gvdiaz/Ensayo-estatico-doc/Documentacion/ICD.odt

Título: Definición de interfaz de PCB de ensayo estático

Fecha de creación: 30/07/2019

Última modificación: 01/08//2019

Autor: Gustavo V. Diaz

Eléctricas

1. Entre generador de señales y PCB ensayo OK
2. Entre sensores de banco y PCB ensayo OK
3. Entre osciloscopio y PCB ensayo OK
4. Entre tester y PCB ensayo OK
5. Entre HMI y PCB ensayo OK
6. Grounding a PCB OK

Mecánicas

1. Fijación en gabinete

Definiciones de interfaz eléctrica

Puerto: Interfaz eléctrica al exterior que se encuentra en el dispositivo a conectar. Por ejemplo el puerto del generador de señales es la interfaz de salida del dispositivo. En este caso el conector BNC de salida.

Tipo eléctrico: Es una definición del pin para que sea utilizada en el momento de llevar estas definiciones a KiCad. El programa diferencia a grandes rasgos entre contactos de potencia y señal. Por lo cual en esta distinción se indica si el contacto pertenece al circuito de potencia o es una señal.

Interfaz eléctrica entre generador de señales y PCB de ensayo

Descripción narrativa

El generador cuenta con un conector de salida BNC. Para que llegue la señal del generador al sensor debo conectarlo al PCB. Esto lo hago mediante un cable coaxil con conectores BNC. Por lo cual el conector de entrada de señal del PCB debe ser BNC a chasis.

Resumen

Puerto de generador

Tipo de conector | Género | Nro. de pin | Función | Observación | Tipo eléctrico
BNC a chasis | Hembra | 1 | SGN | Pin interno | señal
| | 2 | Malla | Exterior conector | señal

Puerto de PCB

Tipo de conector | Género | Nro. de pin | Función | Observación | Tipo eléctrico
BNC a chasis | Hembra | 1 | SGN | Pin interno | señal
| | 2 | Malla | Exterior conector | señal

Designador en PCB: J1

Interfaz definida

Puerto a generador

Tipo de conector | Género | Nro. de pin | Función | Observación | Tipo eléctrico
BNC a cable | Macho | 1 | SGN | Pin interno | señal
| | 2 | Malla | Exterior conector | señal

Puerto a PCB

Tipo de conector | Género | Nro. de pin | Función | Observación | Tipo eléctrico
BNC a cable | Macho | 1 | SGN | Pin interno | señal
| | 2 | Malla | Exterior conector | señal

Detalle de cable

Tipo: Coaxil

Interfaz eléctrica entre sensores de banco y PCB

Descripción narrativa

Los sensores debido al incendio tienen parte de sus cables quemados. Por lo cual hay que proveer de conectores de salida a los mismos. Para estos se decidió utilizar conectores DB con carcasa metálica para continuar el blindaje previsto por el cable del sensor. Estos cuentan con dos contactos unifilares y una malla. En el caso del PCB se eligió conectores DB debido a su bajo costo.

Un agregado importante es indicar que son dos los sensores a ensayar por lo cual se debe realizar doble trabajo en cuanto al puerto de sensor.

Resumen

Puerto de sensor

Tipo de conector | Género | Nro. de pin | Función | Observación | Tipo eléctrico
DB9 a cable | Macho | 1 | - | - | -
| | 2 | SGN blanco | Zs1 | señal
| | 3 | SGN negro | GND | señal
| | 4 | - | - | -
| | 5 | - | - | -
| | 6 | - | - | -
| | 7 | - | - | -
| | 8 | - | - | -
| | 9 | - | - | -
| | Carcaza | Malla | - | -

Puerto de PCB

Tipo de conector | Género | Nro. de pin | Función | Observación | Tipo eléctrico
DB9 a chasis | Hembra | 1 | - | - | -
| | 2 | SGN blanco | Zs1 | señal
| | 3 | SGN negro | GND | señal
| | 4 | - | - | -
| | 5 | - | - | -
| | 6 | - | - | -
| | 7 | - | - | -
| | 8 | - | - | -
| | 9 | - | - | -
| | Carcaza | Malla | GND | -

Designador en PCB: J2

Interfaz definida

Puerto a sensor

Tipo de conector | Género | Nro. de pin | Función | Observación | Tipo eléctrico
DB9 a cable | Hembra | 1 | - | - | -
| | 2 | SGN blanco | - | señal
| | 3 | SGN negro | - | señal
| | 4 | - | - | -
| | 5 | - | - | -
| | 6 | - | - | -
| | 7 | - | - | -
| | 8 | - | - | -
| | 9 | - | - | -
| | Carcaza | Malla | - | -

Puerto a PCB

Tipo de conector | Género | Nro. de pin | Función | Observación | Tipo eléctrico
DB9 a chasis | Macho | 1 | - | - | -
| | 2 | SGN blanco | - | señal
| | 3 | SGN negro | - | señal
| | 4 | - | - | -
| | 5 | - | - | -
| | 6 | - | - | -
| | 7 | - | - | -
| | 8 | - | - | -
| | 9 | - | - | -
| | Carcaza | Malla | - | -

Detalle de cable

Tipo: bifilar 1mm2 mallado

Interfaz eléctrica entre osciloscopio y PCB ensayo

Descripción narrativa

En este caso la interfaz eléctrica que une ambos puertos ya está definida por la punta de osciloscopio. Por lo cual el trabajo de coordinación está relacionado con la definición del puerto en PCB.

Resumen

Puerto de osciloscopio punta 1

Tipo de conector | Género | Nro. de pin | Función | Observación | Tipo eléctrico
BNC a chasis | Hembra | 1 | VGEN | Tensión de generador | señal
| | 2 | GNDGEN | Referencia generador | señal

Puerto de PCB punta 1

Tipo de conector | Género | Nro. de pin | Función | Observación | Tipo eléctrico
Pines a PCB | Macho | 1 | VGEN | Tensión de generador | señal
| | 2 | GNDGEN | Referencia generador | señal

Designador de PCB: TP3 (V1) y TP4 (GND)

Puerto a osciloscopio punta 1

Tipo de conector | Género | Nro. de pin | Función | Observación | Tipo eléctrico
BNC a cable | Macho | 1 | VGEN | Tensión de generador | señal
| | 2 | GNDGEN | Referencia generador | señal

Puerto a PCB

Tipo de conector | Género | Nro. de pin | Función | Observación | Tipo eléctrico
Contacto de punta de osciloscopio | | 1 | VGEN | Tensión de generador | señal
| | 2 | GNDGEN | Referencia generador | señal

Detalle de cable

Tipo: -

Descripción narrativa

Ahora se realiza la misma descripción pero para la punta nro 2 del osciloscopio

Resumen

Puerto de osciloscopio punta 2

Tipo de conector | Género | Nro. de pin | Función | Observación | Tipo eléctrico
BNC a chasis | Hembra | 1 | VZS1 | Tensión de sensor | señal
| | 2 | GNDGEN | Referencia generador | señal

Puerto de PCB punta 2

Tipo de conector | Género | Nro. de pin | Función | Observación | Tipo eléctrico
Pines a PCB | Macho | 1 | VZS1 | Tensión de sensor | señal
| | 2 | GNDGEN | Referencia generador | señal

Designador en PCB: TP5 (V1) y TP6 (GND)

Interfaz definida

Puerto a osciloscopio punta 2

Tipo de conector | Género | Nro. de pin | Función | Observación | Tipo eléctrico
BNC a cable | Macho | 1 | VZS1 | Tensión de sensor | señal
| | 2 | GNDGEN | Referencia generador | señal

Puerto a PCB

Tipo de conector | Género | Nro. de pin | Función | Observación | Tipo eléctrico
Contacto de punta de osciloscopio | | 1 | VZS1 | Tensión de sensor | señal
| | 2 | GNDGEN | Referencia generador | señal

Detalle de cable

Tipo: -

Interfaz eléctrica entre tester y PCB ensayo

Descripción narrativa

En este caso la interfaz eléctrica que une ambos puertos ya está definida por las puntas de medición del tester. Por lo cual el trabajo de coordinación está relacionado con la definición del puerto en PCB.

Designador en PCB: TP1 (positivo) y TP2 (negativo)

Interfaz Grounding a PCB

Todas las interfaces y dispositivos utilizados deberán contar con una referencia al potencial de tierra.

PCB

El contacto de este dispositivo con el grounding será al terminal de GNDGEN. Dicho potencial se distribuye por todas las interfaces, como quedó definido anteriormente. De la misma manera los dispositvos como el generador y osciloscopio están referidos al mismo potencial.

Generador de señales y osciloscopio

Ya tienen incorporado su política de grounding, a la cual me adapto.

Tester

No necesita referencia de grounding pero igualmente toma la misma referencia para medir.

Sensores

Debo verificar que el banco de balanceo se encuentre conectado al potencial de tierra.

Designador en PCB: H1, H2, H3 y H4
