gvdiaz/Ensayo-estatico-doc/Documentacion/Ensayo estatico.odt

Título: Propuesta de ensayo en sensor inductivo estático

Proyecto: Balanceadora de José

Autor/es:

- Gustavo V. Diaz

Objetivo:

Relevar funcionamiento en frecuencia de sensores (izquierdo y derecho) para obtener el módulo y fase de la impedancia del sensor cuando se encuentra estático.

Los objetivos secundarios son relevar comportamiento con otras amplitudes de alimentación y relevar comportamiento cuando el cabezal está desplazado de la posición de reposo.

Circuito general propuesto

Este circuito se propone debido a que ofrece una ventaja teniendo en cuenta que la medición se realizará con un osciloscopio analógico. Se elige colocar la referencia de medición en el nodo B debido a que el osciloscopio puede medir ambas tensiones Va y Vc (necesarias para el ensayo) con ese solo punto de referencia.

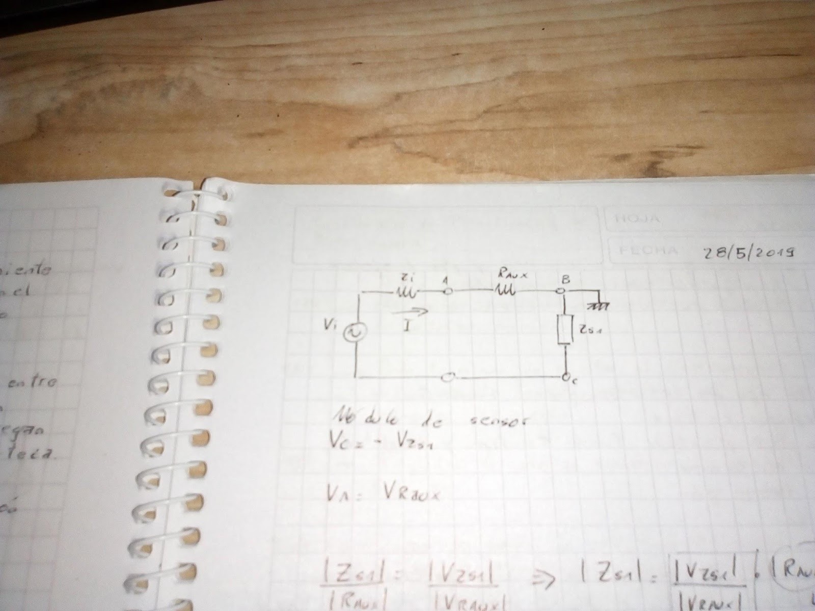
[picture p2: figure]

Ilustración 1: Esquema general de circuito

Si se hubiera elegido como nodo de referencia el C la manera de obtener la tensión Vab hubiera sido restar Va-Vb con lo cual se pone en funcionamiento otro circuito amplificador encargado de la resta de ambas entradas en el osciloscopio con lo cual se aumenta la incerteza de la medición no solo por las puntas sino también por el método utilizado para medir.

La medición que se decidió realizar tiene en cuenta que simplemente se debe invertir la señal medida Vc. Dicha acción no agrega prácticamente incerteza de más, si se lo compara con la resta de señales.

Magnitudes a medir

Dado que se quiere relevar el comportamiento en frecuencia del sensor se debe obtener las siguientes magnitudes:

Z_{S1} = abs{ Z_{S1} } func e^{-j (2 %pi fo+ %alpha_{Z_{S1}} )}

Se conocerá el comportamiento en frecuencia del sensor conociendo el módulo y fase de la impedancia.

Módulo de sensor inductivo

Estas magnitudes se pueden obtener con las siguientes expresiones:

lline {Z_{S1}} rline wideslash {lline {R_{AUX}} rline } = lline {V_{Z_{S1}}} rline wideslash {lline {V_{R_{AUX}}} rline}
newline
newline
lline {Z_{S1}} rline = lline {V_{Z_{S1}}} rline over {lline {V_{R_{AUX}}} rline} cdot lline {R_{AUX}} rline
Expresión 1: Módulo de sensor inductivo

Tanto VZS1 como VRAUX son medidos con el osciloscopio en los valores pico de las ondas medidas. El caso de RAUX su módulo es igual al valor de resistencia cuyo valor se obtiene con el tester.

Fase de sensor inductivo

Parto nuevamente de la definición en fasores de ZS1:

Z_{S1} = abs{ Z_{S1} } func e^{-j (2 %pi fo+ %alpha_{Z_{S1}} )}
newline
Z_{S1} = {abs{ V_{Z_{S1}} } func e^{-j (2 %pi fo+ %alpha_{V_{Z_{S1}}} )}} over {{abs{ I} } func e^{-j (2 %pi fo+ %alpha_{I} )}}
newline
Z_{S1} = R_{AUX} cdot {{abs{ V_{Z_{S1}} } func e^{-j (2 %pi fo+ %alpha_{V_{Z_{S1}}} )}} over {{abs{V_{R_{AUX}}} } func e^{-j (2 %pi fo+ %alpha_{V_{R_{AUX}}} )}}}
newline
Z_{S1} = {{ R_{AUX} cdot abs{ V_{Z_{S1}} }} over {abs{V_{R_{AUX}}}}} cdot { e^{-j [2 %pi fo+ (%alpha_{V_{Z_{S1}}}- %alpha_{V_{R_{AUX}}} )]} }
newline

De donde se obtiene las expresiones de módulo y fase. En particular la expresión de fase del sensor inductivo es:

%alpha_{Z_{S1}} = %alpha_{V_{Z_{S1}}} - %alpha_{V_{R_{AUX}}}
Expresión 2: Fase de sensor inductivo

La medición de dicha magnitud se hace a través de la diferencia de fase entre la tensión del sensor y la tensión de la resistencia auxiliar.

Como conclusión del desarrollo emergen que las mediciones a realizar son:

abs{ V_{Z_{S1}} }:módulo de tensión en sensor inductivo
newline
abs{ V_{R_{AUX}} }: módulo de tensión en resistencia auxiliar
newline
%alpha_{ V_{Z_{S1}} } - %alpha_{ V_{R_{AUX}} }: Diferencia de fase entre sensor y resistencia auxiliar
Expresión 3: Variables a medir

Implementación de medición

Teniendo cómo referencia Ilustración 1: Esquema general de circuito se establece que las mediciones a realizar guardan la siguiente relación con las variables a medir.

V_{Z_{S1}} = - V_{ C } = -V_{ 1 }
newline
V_{R_{AUX}} = V_{ A } = V_{ 2 }

Donde:

- VC: Tensión en nodo C
- V0: Tensión de referencia, en este caso el B
- VA: Tensión en nodo A
- V1: Punta 1 de osciloscopio
- V2: Punta 2 de osciloscopio

Por lo cual lo único que se debe realizar para medir VZS1 es invertir el canal 1. El canal 2 no hace falta que se modifique la fase de la misma.

Ensayos a realizar

Los ensayos a realizar para determinar el comportamiento estático de los sensores inductivos son 6.

Sensor izquierdo

1. Ensayo con tensión nominal (6V) y en posición nominal (en punto de reposo)
2. Ensayo con tensión nominal (6V) y en posición corrida (con tope en cabezal)
3. Ensayo con tensión atenuada (0,6V) y en posición nominal

Secuencia de ensayo nominal (Vin = 6V y posición nominal)

Requerimientos:

- 5 mediciones por década para la variación de frecuencia
- Las frecuencias deben ser elegidas en función de que sean múltiplos de la base de tiempo elegida.

Condiciones iniciales:

- Supongo que cuento con PCB y puntos de medición
- Supongo que cuento con generador de señales
- Supongo que cuento con conexión de sensor

Componentes de ensayo

- Generador de señales
- Cables de alimentación de generador
- Cables de ensayo de generador
- Zapatilla
- Osciloscopio
- Cables de alimentación de osciloscopio
- Puntas de medición de osciloscopio
- PCB de medición
- Separador de cabezal

Secuencia:

1. Acomodar los instrumentos y componentes de manera que sea posible energizar los instrumentos y conectarlos entre si.
2. Energizar los equipos (no habilitar generador)
3. Conectar el osciloscopio con PCB
4. Conectar generador con PCB
5. Conectar banco con PCB
6. Configurar generador de señales y verificar offset
7. Configurar PCB en medición de generador de señales (int.1 e int. 2 posición medición)
8. Habilitar salida de generador de señales
9. Configurar la salida del generador de señales para ensayo
  1. Tensión alimentación 6Vpico
  2. Frecuencia
10. Configurar PCB en medición de ensayo (int. 1 e int. 2 posición ensayo)
11. Configurar osciloscopio para medición de módulo
12. Tomar registro fotográfico y de configuración de osciloscopio
13. Configurar osciloscopio para medición de fase
14. Tomar registro fotográfico y configuración de osciloscopio.
15. Deshabilitar salida de generador de señales
16. Repetir pasos desde punto 6 hasta terminar con las frecuencias preestablecidas y evaluar continuación de ensayo

Secuencia de ensayo con cabezal desplazado (Vin = 6V y posición desplazado)

Requerimientos:

- 3 mediciones por década para la variación de frecuencia
- Las frecuencias deben ser elegidas en función de que sean múltiplos de la base de tiempo elegida.

Condiciones iniciales:

- Supongo que cuento con PCB y puntos de medición
- Supongo que cuento con generador de señales
- Supongo que cuento con conexión de sensor

Componentes de ensayo

- Generador de señales
- Cables de alimentación de generador
- Cables de ensayo de generador
- Zapatilla
- Osciloscopio
- Cables de alimentación de osciloscopio
- Puntas de medición de osciloscopio
- PCB de medición
- Separador de cabezal

Secuencia:

1. Acomodar los instrumentos y componentes de manera que sea posible energizar los instrumentos y conectarlos entre si.
2. Insertar tope para corrimiento de cabezal de sensor
3. Energizar los equipos (no habilitar generador)
4. Conectar el osciloscopio con PCB
5. Conectar generador con PCB
6. Conectar banco con PCB
7. Configurar generador de señales y verificar offset
8. Configurar PCB en medición de generador de señales (int.1 e int. 2 posición medición)
9. Habilitar salida de generador de señales
10. Configurar la salida del generador de señales para ensayo
  1. Tensión alimentación 6Vpico
  2. Frecuencia
11. Configurar PCB en medición de ensayo (int. 1 e int. 2 posición ensayo)
12. Configurar osciloscopio para medición de módulo
13. Tomar registro fotográfico y de configuración de osciloscopio
14. Configurar osciloscopio para medición de fase
15. Tomar registro fotográfico y configuración de osciloscopio.
16. Deshabilitar salida de generador de señales
17. Repetir pasos desde punto 7 hasta terminar con las frecuencias preestablecidas y evaluar continuación de ensayo

Secuencia de ensayo con cabezal desplazado (Vin = 0,6V y posición nominal)

Requerimientos:

- 3 mediciones por década para la variación de frecuencia
- Las frecuencias deben ser elegidas en función de que sean múltiplos de la base de tiempo elegida.

Condiciones iniciales:

- Supongo que cuento con PCB y puntos de medición
- Supongo que cuento con generador de señales
- Supongo que cuento con conexión de sensor

Componentes de ensayo

- Generador de señales
- Cables de alimentación de generador
- Cables de ensayo de generador
- Zapatilla
- Osciloscopio
- Cables de alimentación de osciloscopio
- Puntas de medición de osciloscopio
- PCB de medición
- Separador de cabezal

Secuencia:

1. Acomodar los instrumentos y componentes de manera que sea posible energizar los instrumentos y conectarlos entre si.
2. Insertar tope para corrimiento de cabezal de sensor
3. Energizar los equipos (no habilitar generador)
4. Conectar el osciloscopio con PCB
5. Conectar generador con PCB
6. Conectar banco con PCB
7. Configurar generador de señales y verificar offset
8. Configurar PCB en medición de generador de señales (int.1 e int. 2 posición medición)
9. Habilitar salida de generador de señales
10. Configurar la salida del generador de señales para ensayo
  1. Tensión alimentación 0,6Vpico
  2. Frecuencia inicial
11. Configurar PCB en medición de ensayo (int. 1 e int. 2 posición ensayo)
12. Configurar osciloscopio para medición de módulo
13. Tomar registro fotográfico y de configuración de osciloscopio
14. Configurar osciloscopio para medición de fase
15. Tomar registro fotográfico y configuración de osciloscopio.
16. Deshabilitar salida de generador de señales
17. Repetir pasos desde punto 7 hasta terminar con las frecuencias preestablecidas y evaluar continuación de ensayo

Descripción de banco de medición

Acá debería describir el banco de medición con los bloques que especifiqué en el cuaderno y la descripción de cada uno de los bloques.
