gvdiaz/Ensayo-estatico-doc/Documentacion/Requerimientos PCB ensayo estatico.odt

Última modificación: 19/06/2019

Requerimientos de PCB para ensayo estático

Cumplir con las operaciones requeridas por los ensayos estáticos.

Estas operaciones están descriptas en la secuencia del ensayo

Repaso las operaciones:

Tengo en cuenta la secuencia de ensayo nominal dado que la diferencia entre este ensayo y los otros es que modifica en un caso una condición del sensor (desplazamiento de sensor) y la configuración del generador del señales. No se debe modificar nada relacionado con el PCB

Nro acción | Acción de secuencia | Nro req. | Requerimiento a PCB
1 | Acomodar los instrumentos y componentes de manera que sea posible energizar los instrumentos y conectarlos entre si. | 1 | Diseñar las interfaces eléctricas entre Generador-pcb, Osciloscopio-pcb y sensores-pcb
2 | Energizar los equipos (no habilitar generador) | | -
3 | Conectar el osciloscopio con PCB | | Req. Nro 1
4 | Conectar generador con PCB | | Req. Nro 1
5 | Conectar banco con PCB | | Req. Nro 1
6 | Configurar generador de señales y verificar offset | 5 | El PCB deberá contar con una interfaz para medición de offset con tester.
7 | Configurar PCB en medición de generador de señales (int.1 e int. 2 posición medición) | 2 | El pcb deberá poder ser configurado en modo ensayo o ajuste de generador.
8 | Habilitar salida de generador de señales | 4 | El pcb deberá poder tener una habilitación de señal de entrada propia para el Generador.
9 | Configurar la salida del generador de señales para ensayo | 2.1 | El pcb configurado en ajuste de generador desconecta el circuito de ensayo y conecta directamente los terminales de medición del osciloscopio al generador
10 | Configurar PCB en medición de ensayo (int. 1 e int. 2 posición ensayo) | 2.2 | El pcb configurado en ensayo deberá conectar el circuito de ensayo teniendo en cuenta los puntos de medición del osciloscopio.
11 | Configurar osciloscopio para medición de módulo | 3 | El pcb deberá contemplar la conexión con puntas de osciloscopio para medición en sensor y resistencia auxiliar.
12 | Tomar registro fotográfico y de configuración de osciloscopio | | -
13 | Configurar osciloscopio para medición de fase | | -
14 | Tomar registro fotográfico y configuración de osciloscopio. | | -
15 | Deshabilitar salida de generador de señales | 4 | El pcb deberá poder tener una habilitación de señal de entrada propia para el Generador.
16 | Repetir pasos desde punto 6 hasta terminar con las frecuencias preestablecidas | | -

Resumen de requerimientos:

Funcionales

1. Diseñar las interfaces eléctricas entre Generador-pcb, Osciloscopio-pcb y sensores-pcb
2. El pcb deberá poder ser configurado en modo ensayo o ajuste de generador.
  1. El pcb configurado en ajuste de generador desconecta el circuito de ensayo y conecta directamente los terminales de medición del osciloscopio al generador.
  2. El pcb configurado en ensayo deberá conectar el circuito de ensayo teniendo en cuenta los puntos de medición del osciloscopio.
3. El pcb deberá contemplar la conexión con puntas de osciloscopio para medición en sensor y resistencia auxiliar.
4. El pcb deberá poder tener una habilitación de señal de entrada propia para el Generador.
5. El PCB deberá contar con una interfaz para medición de offset con tester.

Miscelaneos

1. Identificar version de pcb
2. Deberá contemplar agujeros de soporte
3. Deberá implementar prácticas de protección electroestática y de grounding
4. Deberá adaptarse a la implementación de interfaz eléctrica que se consiga en los proveedores.
