gvdiaz/Ensayo-estatico-doc/Documentacion/Tabla de ensayo estatico.pdf

SI 6V nominal

Página 1

Fecha:
Sensor: | Inductivo izquierdo
Tensión alimentación: 6 Vac
Posición cabezal: | Nominal
Nro | Vin; Posición cabezal | Frecuencia | Hora fotografía | Canal 1 | Canal 2 | Observaciones | Magnificador (si/no)
1 a | 6V; nominal | 50
1 b | 6V; nominal | 50
2 a | 6V; nominal | 100
2 b | 6V; nominal | 100
3 a | 6V; nominal | 200
3 b | 6V; nominal | 200
4 a | 6V; nominal | 500
4 b | 6V; nominal | 500
5 a | 6V; nominal | 1000
5 b | 6V; nominal | 1000
6 a | 6V; nominal | 2000
6 b | 6V; nominal | 2000
7 a | 6V; nominal | 5000
7 b | 6V; nominal | 5000
8 a | 6V; nominal | 10000
8 b | 6V; nominal | 10000
9 a | 6V; nominal | 20000
9 b | 6V; nominal | 20000
10 a | 6V; nominal | 50000
10 b | 6V; nominal | 50000
11 a | 6V; nominal | 100000
11 b | 6V; nominal | 100000

SI 6V corrido

Página 2

Fecha:
Sensor: | Inductivo izquierdo
Tensión alimentación: 6 Vac
Posición cabezal: | Corrido
Nro | Vin; Posición cabezal | Frecuencia | Hora fotografí Canal 1 | Canal 2 | Observaciones | Magnificador (si/no)
1 a | 6V; corrido | 50
1 b | 6V; corrido | 50
2 a | 6V; corrido | 100
2 b | 6V; corrido | 100
3 a | 6V; corrido | 200
3 b | 6V; corrido | 200
4 a | 6V; corrido | 500
4 b | 6V; corrido | 500
5 a | 6V; corrido | 1000
5 b | 6V; corrido | 1000
6 a | 6V; corrido | 2000
6 b | 6V; corrido | 2000
7 a | 6V; corrido | 5000
7 b | 6V; corrido | 5000
8 a | 6V; corrido | 10000
8 b | 6V; corrido | 10000
9 a | 6V; corrido | 20000
9 b | 6V; corrido | 20000
10 a | 6V; corrido | 50000
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
2,00E-05 | 0,0002 | 5000
5,00E-05 | 0,0005 | 2000
1,00E-04 | 0,001 | 1000
2,00E-04 | 0,002 | 500
5,00E-04 | 0,005 | 200
1,00E-03 | 0,01 | 100
2,00E-03 | 0,02 | 50
5,00E-03 | 0,05 | 20
1,00E-02 | 0,1 | 10
2,00E-02 | 0,2 | 5
5,00E-02 | 0,5 | 2
1,00E-01 | 1 | 1
2,00E-01 | 2 | 0,5
