gvdiaz/Ensayo-estatico-doc/Documentacion/Materiales de ensayos.ods

Materiales para ensayo estático
Fuente: | Los materiales fueron listados teniendo en cuenta las operaciones necesarias en el ensayo, el esquema del ensayo y el documento de requerimientos del PCB
nro | Componente | Cantidad | Cantidad mín. | Uso
1 | R 15k 1% | 10 | 1 | Resistencia de medición
2 | Conector BNC a PCB | 4 | 1 | Interfaz elec. GEN.
3 | Punto med. PCB | 4 | 2 | Interfaz elec. OSC
4 | Conector bifilar mallado macho a cable | 6 | 4 | Interfaz elec. De sensor y extensor
5 | Conector bifilar mallado hembra a cable | 2 | 1 | Interfaz elec. A PCB sensores
6 | Conector bifiliar hembra a PCB | 2 | 1 | Interfaz elec. A PCB sensores
7 | Interruptor a PCB 2D2T | 4 | 2 | Interruptor de ensayo/medición GEN
8 | Interruptor a PCB 1D2T | 2 | 1 | Interruptor de habilitación de GEN
9 | Gabinete de PCB | 1 | 1 | Contenedor de PCB
10 | Tornillos de fijación | 10 | 4 | Fijación de PCB
11 | Separadores | 10 | 4 | Fijación de PCB
12 | Arandelas | 10 | 8 | Fijación de PCB
13 | Tuercas | 10 | 4 | Fijación de PCB
Materiales para ensayo sensor contador vueltas y desplazamiento
nro | Componente | Cantidad | Cantidad mín. | Uso
1 | Sensor infrarojo | 4 | 2 | Sensor de desplazamiento y contador de vueltas
2
3
4
5
6
7
