gvdiaz/Ensayo-estatico-doc/Documentacion/Costo ensayo.ods

Archivo de costos
Proyecto: | PCB ensayo estático
Autor: | Gustavo V. Diaz
Fecha inicio | 28/08/19
Fecha modificación | 18/09/19
Nro | costo | Descripción | Comprobante | Fecha | Razón social | Cobrado
1 | 230 | PCB | no me dió | 26/08/19 | F. Arredondo | No
2 | 738 | Componentes | 06-15335 | 14/06/19 | uElectrónica | No
3 | 211 | Componentes | 06-15821 | 02/09/19 | uElectrónica | No
4 | 362 | Componentes | 06-85072 | 14/06/19 | SYC | No
5 | 83,27 | Componente | 05-73481 | 17/09/19 | uElectrónica | No
6
7
8
9
10
11
12
13
14
Total | 1624,27
