gvdiaz/Ensayo-estatico-doc/Documentacion/Kicad Like a Pro 2 illustrations.pdf

# The Kicad design workflow

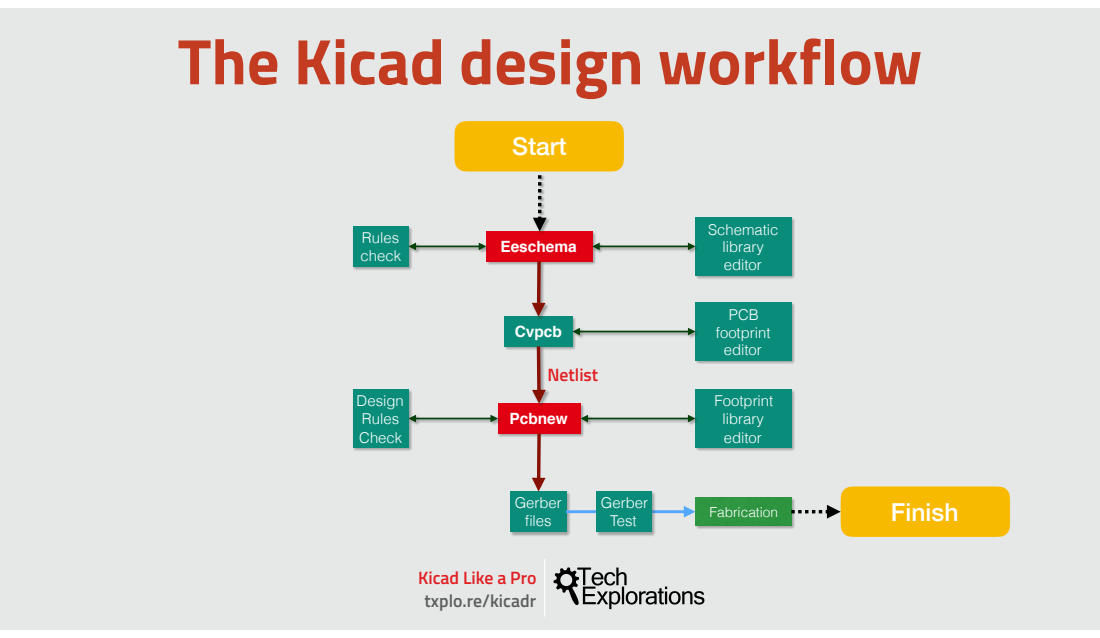
[picture p5: page 1]
Eeschema; Cvpcb; Pcbnew; Design Rules Check; PCB footprint editor; Gerber; files; Fabrication; Rules check; Schematic library editor; Footprint library editor; Start; Test; Finish; Netlist

Kicad Like a Pro
txplo.re/kicadr

# The schematic design process

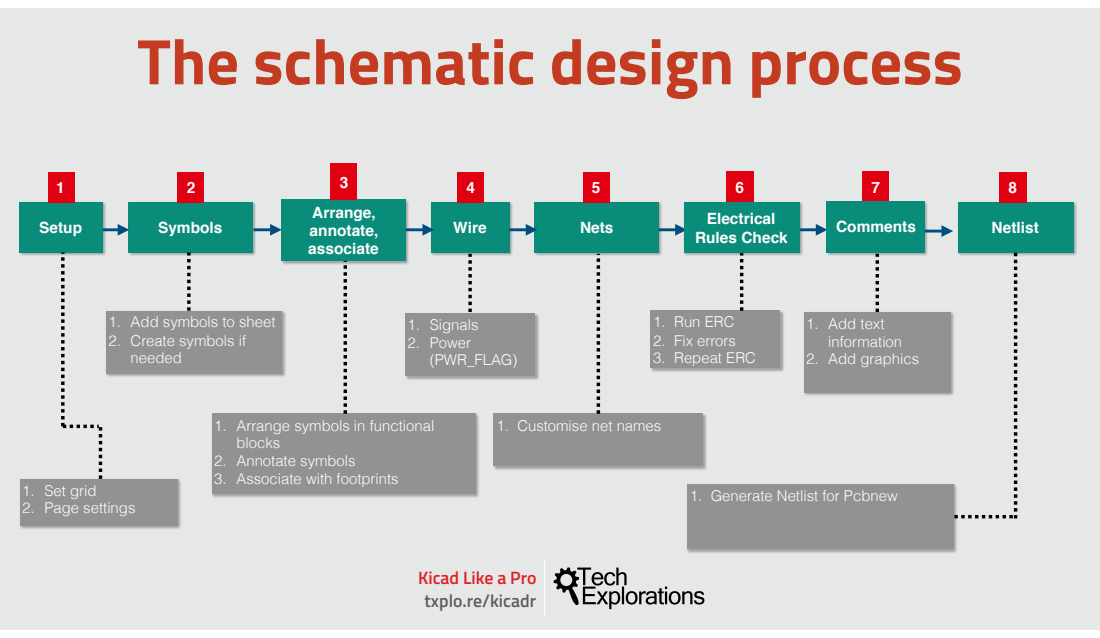
[picture p6: page 2]
1. Signals 2. Power (PWR_FLAG); Setup; Symbols; Arrange, annotate, associate; Wire; Nets; Netlist; 1. Set grid 2. Page settings; 1. Run ERC 2. Fix errors 3. Repeat ERC; Comments Electrical Rules Check; 1. Add text information 2. Add graphics

1. Add symbols to sheet
2. Create symbols if
needed

1. Arrange symbols in functional
blocks
2. Annotate symbols
3. Associate with footprints

1. Customise net names

1. Generate Netlist for Pcbnew

Kicad Like a Pro
txplo.re/kicadr

# The PCB layout process

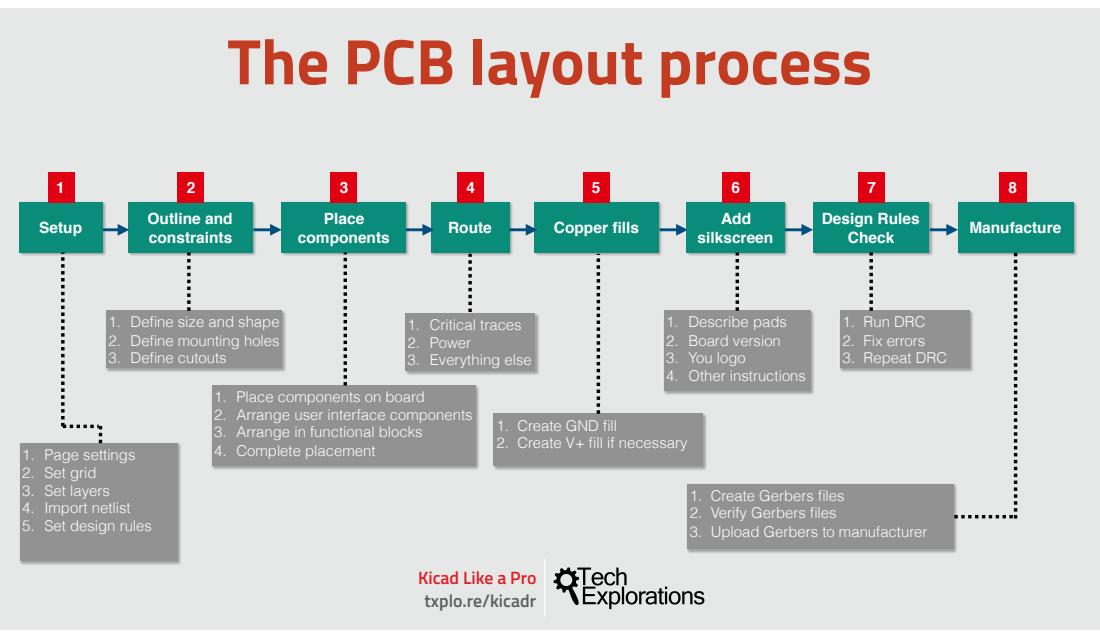
[picture p7: page 3]
1. Critical traces 2. Power 3. Everything else; Setup; Outline and constraints; Place components; Route; Copper fills; Design Rules Check; Manufacture; 1. Run DRC 2. Fix errors 3. Repeat DRC; Add silkscreen; 1. Describe pads 2. Board version 3. You logo 4. Other instructions

1. Define size and shape
2. Define mounting holes
3. Define cutouts

1. Place components on board
2. Arrange user interface components
3. Arrange in functional blocks
4. Complete placement

1. Create GND fill
2. Create V+ fill if necessary

1. Page settings
2. Set grid
3. Set layers
4. Import netlist
5. Set design rules

1. Create Gerbers files
2. Verify Gerbers files
3. Upload Gerbers to manufacturer

Kicad Like a Pro
txplo.re/kicadr

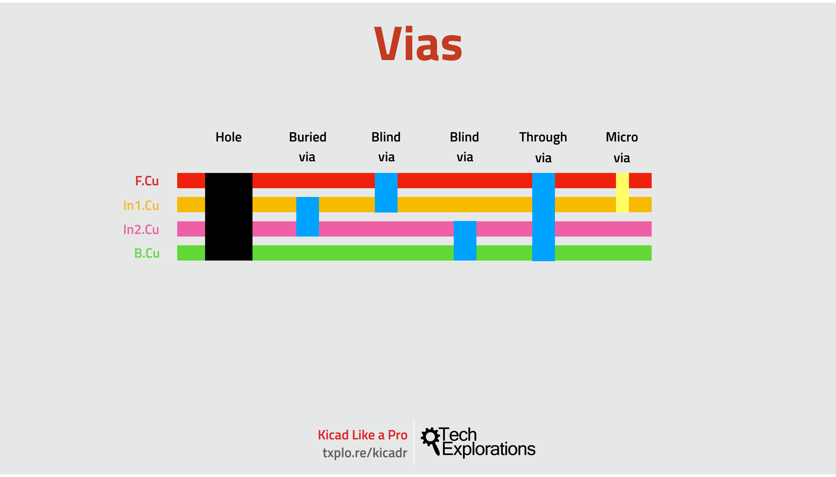
[picture p8: figure]
Kicad Like a Pro txplo.re/kicadr; Vias; Hole; Buried; via; Blind via; Micro via; Through via

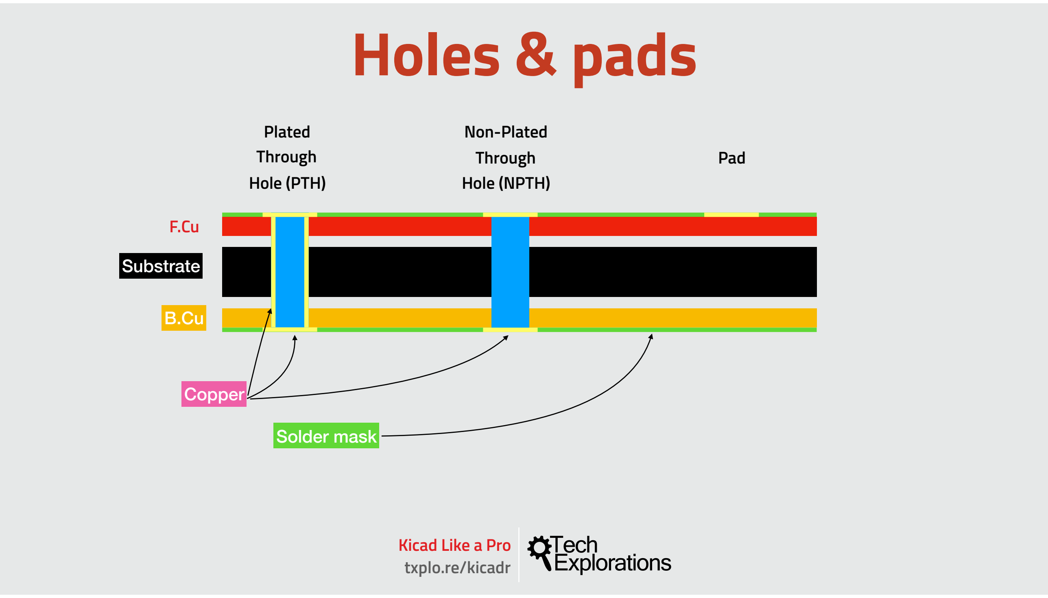
[picture p9: figure]
Kicad Like a Pro txplo.re/kicadr; Holes & pads; Substrate; Plated Through Hole (PTH); Non-Plated Through Hole (NPTH); Solder mask; Copper; Pad
