gvdiaz/Ensayo-estatico-doc/Documentacion/Sim/Banco medicion.asc

L1: ind; 0.1
R1: res; 15k
R2: res; 2k
Vac: voltage; SINE(0 6 1k 0 0 0 5)
Named nets: 0, V1, V2
.tran 0 5m 0
