gvdiaz/Ensayo-estatico-doc/(commit log)

2019-07-30 Estructuré los archivos para hacer control de versiones y repasé los requerimientos del PCB para ya mañana empezar su diseño o continuar con el proceso del libro
    [Cumplimiento requerimientos PCB.ods, Materiales de ensayos.ods, Tabla de ensayo estatico.ods]
2019-07-31 Definición de interfaces eléctricas en documento ICD
2019-07-31 Update ICD.odt
    Continúo la descripción del documento ICD. Hasta ahora terminé con las interfaces de generador, las dos de osciloscopio y tester.
2019-08-01 Terminé la primer versión del documento ICD
2019-08-02 No se aclaró que los conectores de los sensores era DB9 en documento de interfaces
2019-08-05 Se agregó en cada interfaz el designador utilizado en el PCB en cada puerto a PCB
2019-08-07 Agregué en el ICD la netlist del esquemático de cada pin
2019-08-08 Documento y simulación de procedimiento de medición en banco de ensayo estático
2019-08-08 Avancé en el procedimiento de medición hasta ajuste de generador
2019-08-08 Modificaciones intrascendentes en la simulación de banco de medición
2019-08-09 Nuevamente cambio intrascendente en la simulación, solo la hora de guardado. Aproveché para excluir los archivos .log, op.raw y raw de la simulación
2019-08-09 Terminé primer version de procedimiento de medición, debería ir actualizándolo cuando lo haga
2019-08-23 Empecé a ordenar el procedimiento de medición, puse tablas en vez de pasos sueltos
2019-08-26 Terminé de modificar el procedimiento de medición, ya estaría para prepara la jornada de medición. Habría que relevar que materiales me faltan
2019-08-28 Agregué archivo de costos de ensayo, después le paso la factura, jejeje
    [Costo ensayo.ods]
2019-09-06 Actualización de control de costos de ensayo
    [Costo ensayo.ods]
2019-09-06 Olvidé actualizar la fecha de modificación en documento
    [Costo ensayo.ods]
2019-09-18 Update Costo ensayo.ods
    Agregué el optoacoplador que compré esta semana para el contador de vueltas de la balanceadora.
    [Costo ensayo.ods]
2019-10-03 Emprolijamiento de tablas para realizar mediciones de ensayo
    [Tabla de ensayo estatico.ods]
2019-10-04 Update Tabla de ensayo estatico.ods
    Agregué bordes en las tablas de ensayo.
    [Tabla de ensayo estatico.ods]
2019-10-04 Create Tabla de ensayo estatico.pdf
    Archivo para imprimir tablas de ensayo.
2019-11-12 Modificaciones correspondientes a nuevo ensayo el día 17/11/2019 teniendo en cuenta registro de osciloscopio y sus adquisiciones
2019-11-13 Modificación de procedimiento y tabla de ensayo para ensayo de 17/11, no quedaría muchos cambios
    [Tabla de ensayo estatico.ods]
